chrisdaun/pi-zero-serial-hat/(notices)

Notices in the files:
KiCAD/pi-zero-serial-hat.sch:
This Schematic is licensed under MIT Open Source License.
